jugih-official/can-emulator/case/can-emulator-case-print.3mf

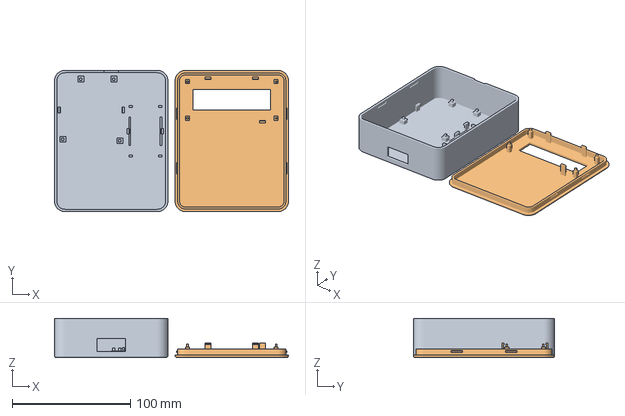
[picture p10: CAD file, 2026-10-12]
case/can-emulator-case-print.3mf
198.0 x 119.5 x 33.0 mm
Case base
Case lid
