jugih-official/can-emulator/case/can-emulator-case-base.stl

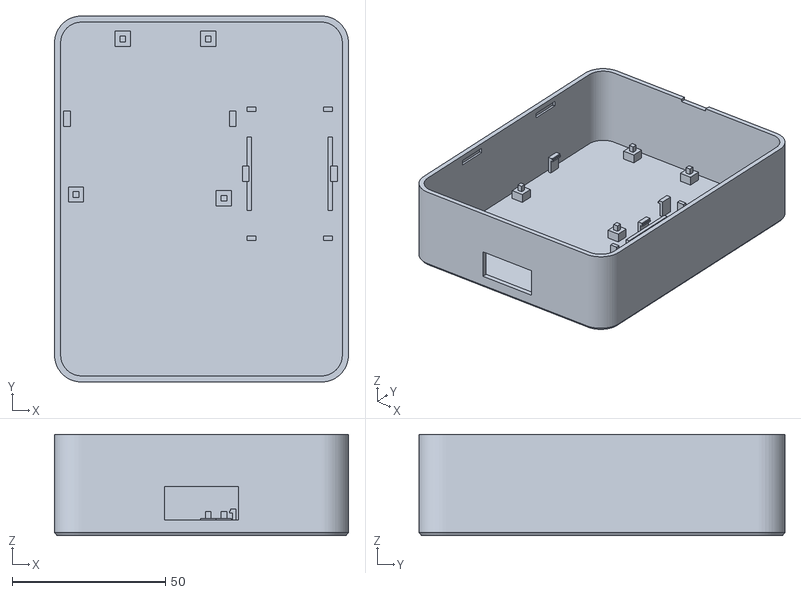
[picture p11: CAD file, 2026-10-12]
case/can-emulator-case-base.stl
96.0 x 119.5 x 33.0
