jugih-official/can-emulator/case/can-emulator-case-lid.stl

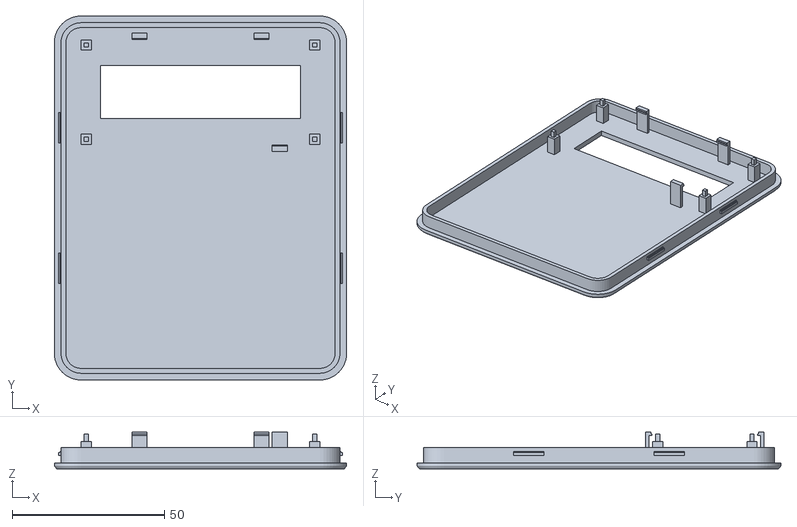
[picture p12: CAD file, 2026-10-10]
case/can-emulator-case-lid.stl
96.0 x 119.5 x 12.1
