jugih-official/can-emulator/(commit log)

2026-08-22 Add VW MQB Klemme 15 CAN emulator for Arduino Uno + MCP2515
    Broadcasts Klemmen_Status_01 (0x3C0) at 100 ms on the Komfort-/
    Infotainment-CAN so bench-harnessed modules see "ignition on" without a
    BCM, steering column module or immobiliser present. Ignition toggles via
    a push button on D4 or the serial console.
    The frame's checksum is CRC-8/AUTOSAR (poly 0x2F, init 0xFF, xorout 0xFF)
    over bytes 1-3 plus magic byte 0xC3. Published bench setups hardcode a
    16-entry checksum table instead, which only covers byte2 == 0x03 and so
    can only ever mean "ignition on"; computing the CRC yields valid frames
    for ignition off, Klemme X and cranking too. All 16 published reference
    values reduce to that sing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
2026-08-22 Add check.sh and verify the sketch builds for real AVR
    The sketch had only ever been compile-checked against stubbed Arduino and
    MCP_CAN headers. With arduino-cli, the arduino:avr core and coryjfowler's
    mcp_can library installed, it now builds for arduino:avr:uno with no
    warnings from any file in this repo: 8118 bytes flash (25%), 562 bytes
    RAM (27%).
    check.sh runs the host tests and that compile together, so a change can
    be verified in one command. Documentation updated to drop the stale note
    that arduino-cli was unavailable, and to record the footprint and the
    rootless install path.
    Still not hardware-verified: no board has been connected.
2026-10-10 LCD, listen-only mode, wiring drawings and a receive path that survives the bench
    Verified against a J533 gateway: ODIS reads "Terminal 15 status via CAN"
    on and off following the emulator.
    - 16x2 LCD on A0-A5 shows terminal state and counters; the status LED is
    now an off-by-default option.
    - Listen-only mode ('l', LISTEN_ONLY_DEFAULT) for sniffing a complete car:
    nothing is transmitted, not even acknowledge bits.
    - 0x5F0 and 0x6B2 are withheld while another node sends them. A gateway
    sends 0x6B2 itself.
    - Frames are read from the MCP2515 by the sketch instead of mcp_can, whose
    readMsgBuf overruns its 8-byte buffer into its own SPI pointer and
    chip-select pin when the DLC registe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
2026-10-10 One-button menu on the LCD, with a bus monitor
    A short press still toggles Klemme 15; holding the button opens a menu for
    Klemme X, the starter request, dimming, the clock, listen-only mode and the
    controller's health. The bus monitor shows frames per second and, per ID,
    the interval and the latest payload, so the box works as a sniffer without
    a laptop.
    Serial 'b' / 'B' inject a short / long press and 'v' prints what the LCD
    shows, which is how the menu was walked through on the bench.
    [can-emulator.ino, config.h]
2026-10-10 The J533 gateway as a permanent part of the bench
    The bench exists to diagnose, code and flash control units through the
    gateway, so the docs now describe it that way: a drawing of the gateway
    with the emulator on its convenience bus, the OBD socket on the diagnostic
    bus and the units under test on theirs; a pin table; what the gateway
    sends; what has been verified with ODIS and what has not; and what to
    watch before flashing, above all that nothing may reset the Uno.
    0x6B2 at 1000 ms is now a measured cycle time.
2026-10-10 Remember ignition across resets; gateway drawing reduced to the wiring
    Klemme 15, Klemme X and listen-only are stored in EEPROM and restored at
    boot, so a reset or a power cut no longer drops the ignition under a
    tester. Klemme 50 is not stored. Builds clean; not yet run on the board.
    The gateway bench drawing now shows wiring only, with the gateway the
    size of the other parts and without the control-unit box.
    [can-emulator.ino, config.h]
2026-10-10 Drawings: wiring only, no captions, legend or notes
    The Uno wiring drawing and the no-gateway bench drawing lose their titles,
    legend, footnotes and explanatory sentences, and are cropped to what is
    left: boards, wires, pin names and wire labels.
2026-10-10 Home screen with voltage and icons, who is awake, learning view
    - Home screen: Klemme 15 state and the supply voltage on the first line;
    icons for Klemme 30, 15, 58 and a diagnostic tester, with the counters,
    on the second. In listen-only the key icon follows the car's own 0x3C0.
    - The voltage is read from the bus. No public DBC carries a Klemme 30
    voltage for MQB, so the source (0x663 byte 0, 0.1 V/bit) is a candidate
    from one bench capture, configurable, and shown with '~' until
    VOLTAGE_VERIFIED is set.
    - Bus monitor: a page listing the units that send network management
    (0x1B0000xx), by node address. Passive, so safe beside a tester.
    - Bus monitor ID pages are a learning view: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
2026-10-10 A simulator: the sketch on a PC, with the LCD in a browser
    sim/ compiles can-emulator.ino for the host, as arduino-cli preprocesses
    it, against stand-ins for the Arduino core, the MCP2515, mcp_can,
    LiquidCrystal and the EEPROM. A page at 127.0.0.1:8515 draws the display
    dot by dot and offers the button, reset, the serial console and a bench:
    the gateway with its measured traffic, a radio, a tester, a car's own
    ignition, the module's 5 V and the supply voltage.
    sim/smoke.sh runs the sketch through its screens and checks the LCD
    contents; check.sh now includes it. That is the first run of the menu,
    the icons, the voltage display, who-is-awake, the learning view, the
    remembered ignition and th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
    [can-emulator.ino, server.py]
2026-10-10 Simulator builds with g++ and python3 alone
    It called arduino-cli to preprocess the sketch, which needs the Arduino
    libraries installed and failed on a machine without LiquidCrystal. A small
    script now adds the function prototypes instead.
2026-10-10 Home screen: pendulums instead of frame counters
    A running number says little at a glance. The second line now shows tx and
    rx each with a pendulum that swings while frames go out and come in, a dash
    when that direction has stopped, and '!' on tx while frames fail to send.
    The count of failed frames appears only once there are any.
    The who-is-awake list is sorted by address so it does not reshuffle.
    [can-emulator.ino, sim_main.cpp]
2026-10-10 One waving radio-wave icon for healthy traffic; a steadier frames table
    Home screen: the tx/rx pendulums give way to a single radio-wave symbol
    that waves in four stages while frames go out acknowledged (in listen-only:
    while they come in), '!' while they fail, a dash when nothing moves.
    The unverified-voltage mark is now '?': on the HD44780 the code of '~' is a
    right arrow. The simulator's font follows the display there.
    Simulator page: the narrow, jumping "what the emulator sends" box becomes a
    full-width table of every frame on the bus, sent and received, with a
    column saying what each one is; rows stay put and only the numbers change.
    [can-emulator.ino, config.h, sim_main.cpp]
2026-10-10 Two-cell icons: car battery, car key, instrument cluster, diagnostic socket
    Each home-screen icon is now drawn across two character cells, with a
    space between icons. That takes all eight user characters of the display,
    so the wave is made of its own characters: a dot sending out arcs.
    While frames fail, the wave gives way to '!' and the count; a '!' stays in
    the last cell after any failure.
    PROTOCOL.md records what a search for a supply-voltage message found: none
    for MQB in the public databases, BSG_Last 0x570 on the older PQ platform,
    and the request-based OBD PID 42 and UDS measured values.
    [can-emulator.ino, sim_main.cpp]
2026-10-10 Home screen: icons side by side, drawn wave in the corner, no KL15 text
    The four icons sit next to each other and the radio wave is a drawn symbol
    again, in the lower right corner. Eight user characters are all the
    display has: the key now uses one (its blade is the display's own '-')
    and the wave animates by redrawing a single character in place.
    The "KL15 ON / OFF" text is gone, the key icon says it. The left of the
    first line names only the exceptions: listen-only, cranking, Klemme X, a
    failed boot check.
    [can-emulator.ino, sim_main.cpp]
2026-10-10 Ignition as text, not an icon; the failed-frame count gets a label
    The key icon is gone. The upper left corner says "Ign on" or "Ign off",
    "Cranking" while Klemme 50 is held and "Listen" in listen-only mode. Three
    icons remain: battery, instrument cluster, diagnostic socket.
    The number before the wave was the count of frames that failed to send,
    shown as "e 1". It now reads "err 1".
    [can-emulator.ino, sim_main.cpp]
2026-10-10 A cleaner diagnostic-socket icon
    The outline of the socket with two rows of pins and nothing else; the bar
    across the middle made it read as a face.
2026-10-10 Diagnostic-socket icon with rounded corners
2026-10-10 A printed case, drawn for HelCAD
    Two parts that snap together without screws: a base that holds the Uno on
    four posts with pins and the MCP2515 module by its edges, and a lid that
    carries the display behind a window the size of its viewing area. One hole
    in the lower side for the CAN pair, the supply and the button's wires.
    96 x 119.5 x 35 mm; the height is the Dupont plugs standing in the Uno's
    sockets.
    case/gen builds both parts from boxes with HelCAD's own core: it works the
    surface out exactly, keeps the boxes as each solid's steps, writes the
    drawing and the STL files, and checks that the boards fit, that lid and base
    do not overlap and that the USB plug clears the display's wiring.
    D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
    [can-emulator-case-base.stl, can-emulator-case-lid.stl]
2026-10-10 The case's drawings come out the same on every run
    HelCAD names each object by a random number and keeps them in no order, so
    regenerating changed every file without changing anything. The generator
    now orders and numbers the objects itself, and reads each drawing back with
    HelCAD's own reader before writing it.
2026-10-10 Fix the case generator, which the last commit left not compiling
    The counter for the drawings' identifier series was declared after its
    first use. The drawings in that commit were still the ones from the run
    before it; they are regenerated here, each in a series of its own.
2026-10-10 Round the case's corners and bevel its top and bottom edges
    The four corners are rounded to 8.8 mm in plan, as far as they go before the
    display's posts, and a bevel of 0.8 x 1 mm runs round the lid's top edge and
    the base's bottom edge. The wall keeps its 2 mm round the bend. The generator
    does not cut any of this: it bends the exact box mesh, the same way for both
    parts, so the fit and the closed surface carry over, and it refuses a radius
    that would bend a post, a hook or a board's place.
    The STL files were also exported through HelCAD's own Save As, from each
    part's drawing and from the assembled one with the other layers hidden, and
    every file checked as one closed, consistently wound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
    [can-emulator-case-base.stl, can-emulator-case-lid.stl]
2026-10-11 Bench: what the convenience bus shows with a unit on the powertrain pair
2026-10-11 The displayed voltage read 12.0 V with the supply at 12.49 V
2026-10-11 VIN_01 (0x6B4) on request: V and 17 characters on the console send a VIN
    On a car the gateway sends this message; the emulator can now stand in for
    one towards the units on its bus. Off until typed, not kept across a reset,
    withheld while another node sends the ID. The component-protection bytes go
    out as zero and the 200 ms cycle is assumed.
    [can-emulator.ino, config.h, mqb_vin.cpp, mqb_vin.h]
2026-10-11 Supply voltage from byte 5 of 0x663, 0.05 V per bit plus 5 V
    The gateway's own measured value (ODIS, $2A07) read 12.720 V while that byte
    flickered between 0x9A and 0x9B, 12.70 and 12.75 V. Byte 0, the first guess,
    is a constant. Still marked unverified: one voltage is one point.
2026-10-11 Bench: a second voltage reading does not bear the byte 5 scaling out
2026-10-11 Bench: the gateway's terminal 30 voltage ($0286) reads 12.6 V, and no byte on the bus says so
2026-10-11 Bench: a multimeter reads 12.63 V, so terminal 30 ($0286) is the true voltage
2026-10-11 The display shows the gateway's supposed battery voltage, marked unverified
2026-10-11 Bench: the ignition state comes back after a reset on the real board
2026-10-11 Bench drawing: the head unit's USB module and its 12 V to 5 V converter
    The USB module hangs on the head unit by its data cable and is on no CAN
    bus. It takes +12 V and ground from the fused supply and +5 V from a
    converter on the same rails. The supply rails move down in the drawing to
    make room under the head unit. Pin numbers of the module are not known yet.
2026-10-12 Case: new pictures from HelCAD, and one 3MF with both halves laid out for the printer
    The pictures are the owner's: the case closed, with the lid's layer off, and
    the two halves as Orient leaves them for printing. The generator now also
    writes can-emulator-case-print.3mf, HelCAD's Export 3D printing of the base
    and the lid on one bed, beside the STL of each.
    [can-emulator-case-print.3mf]
2026-10-12 A screenshot of the simulator in the README and the usage page
    Taken from the simulator itself with the gateway, the radio and the tester
    switched on and the ignition on.
2026-10-12 README cut to the facts
2026-10-12 Change project name to 'VW MQB Ignition switch emulator'
    Updated project title and description in README.
2026-10-12 README: the button and the menu
2026-10-12 Case: the CAN module is 40 x 28 mm, measured
    [can-emulator-case-base.stl, can-emulator-case-print.3mf]
2026-10-12 Case: photos of the printed case
2026-10-12 Update README to remove gateway wiring section
    Removed section about emulator wiring without a gateway.
2026-10-12 Update README with additional case images
    Added alternative image tags for printed case.
2026-10-12 Update README to include closed case image
    Replaced the closed case image with a new one.
